WebmasterTD/uEther/README.md

# uEther

uEther is Ethernet exansion card designed for [Clockwork uConsole](https://www.clockworkpi.com/uconsole).

Based on the microchip LAN9500A USB 2.0 to 10/100 Ethernet Bridge.
