WebmasterTD/uEther/3D/uEtherPanel.step

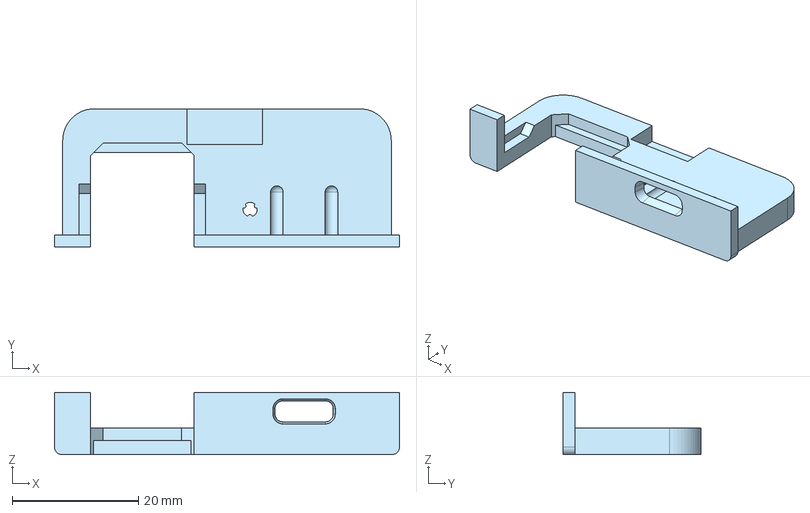
[picture p1: CAD file, 2025-06-16]
3D/uEtherPanel.step
54.6 x 21.9 x 9.85 mm
