WebmasterTD/uEther/(list of files, cad)

Other CAD files:
3D/uEtherPanel.3mf
