WebmasterTD/uEther/docs/2410010003_Korean-Hroparts-Elec-TYPE-C-31-M-12_C165948.pdf

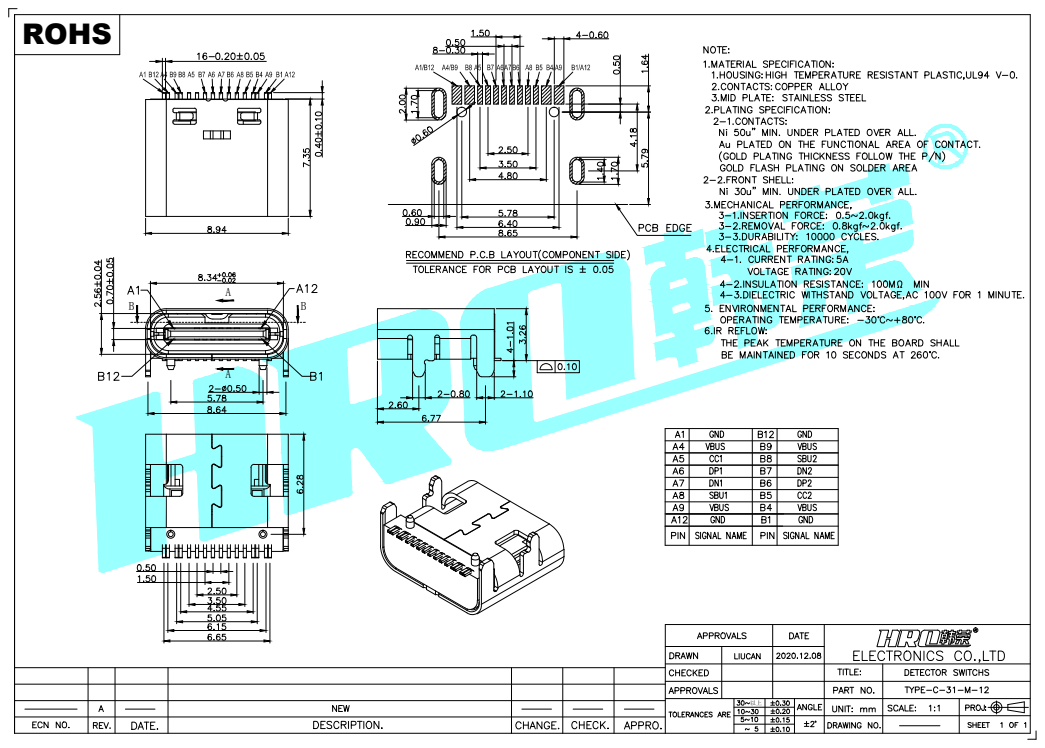
[picture p2: page 1]
