WebmasterTD/uEther/docs/2504101957_XUNPU-RJ45-005-014-11_C7421399.pdf

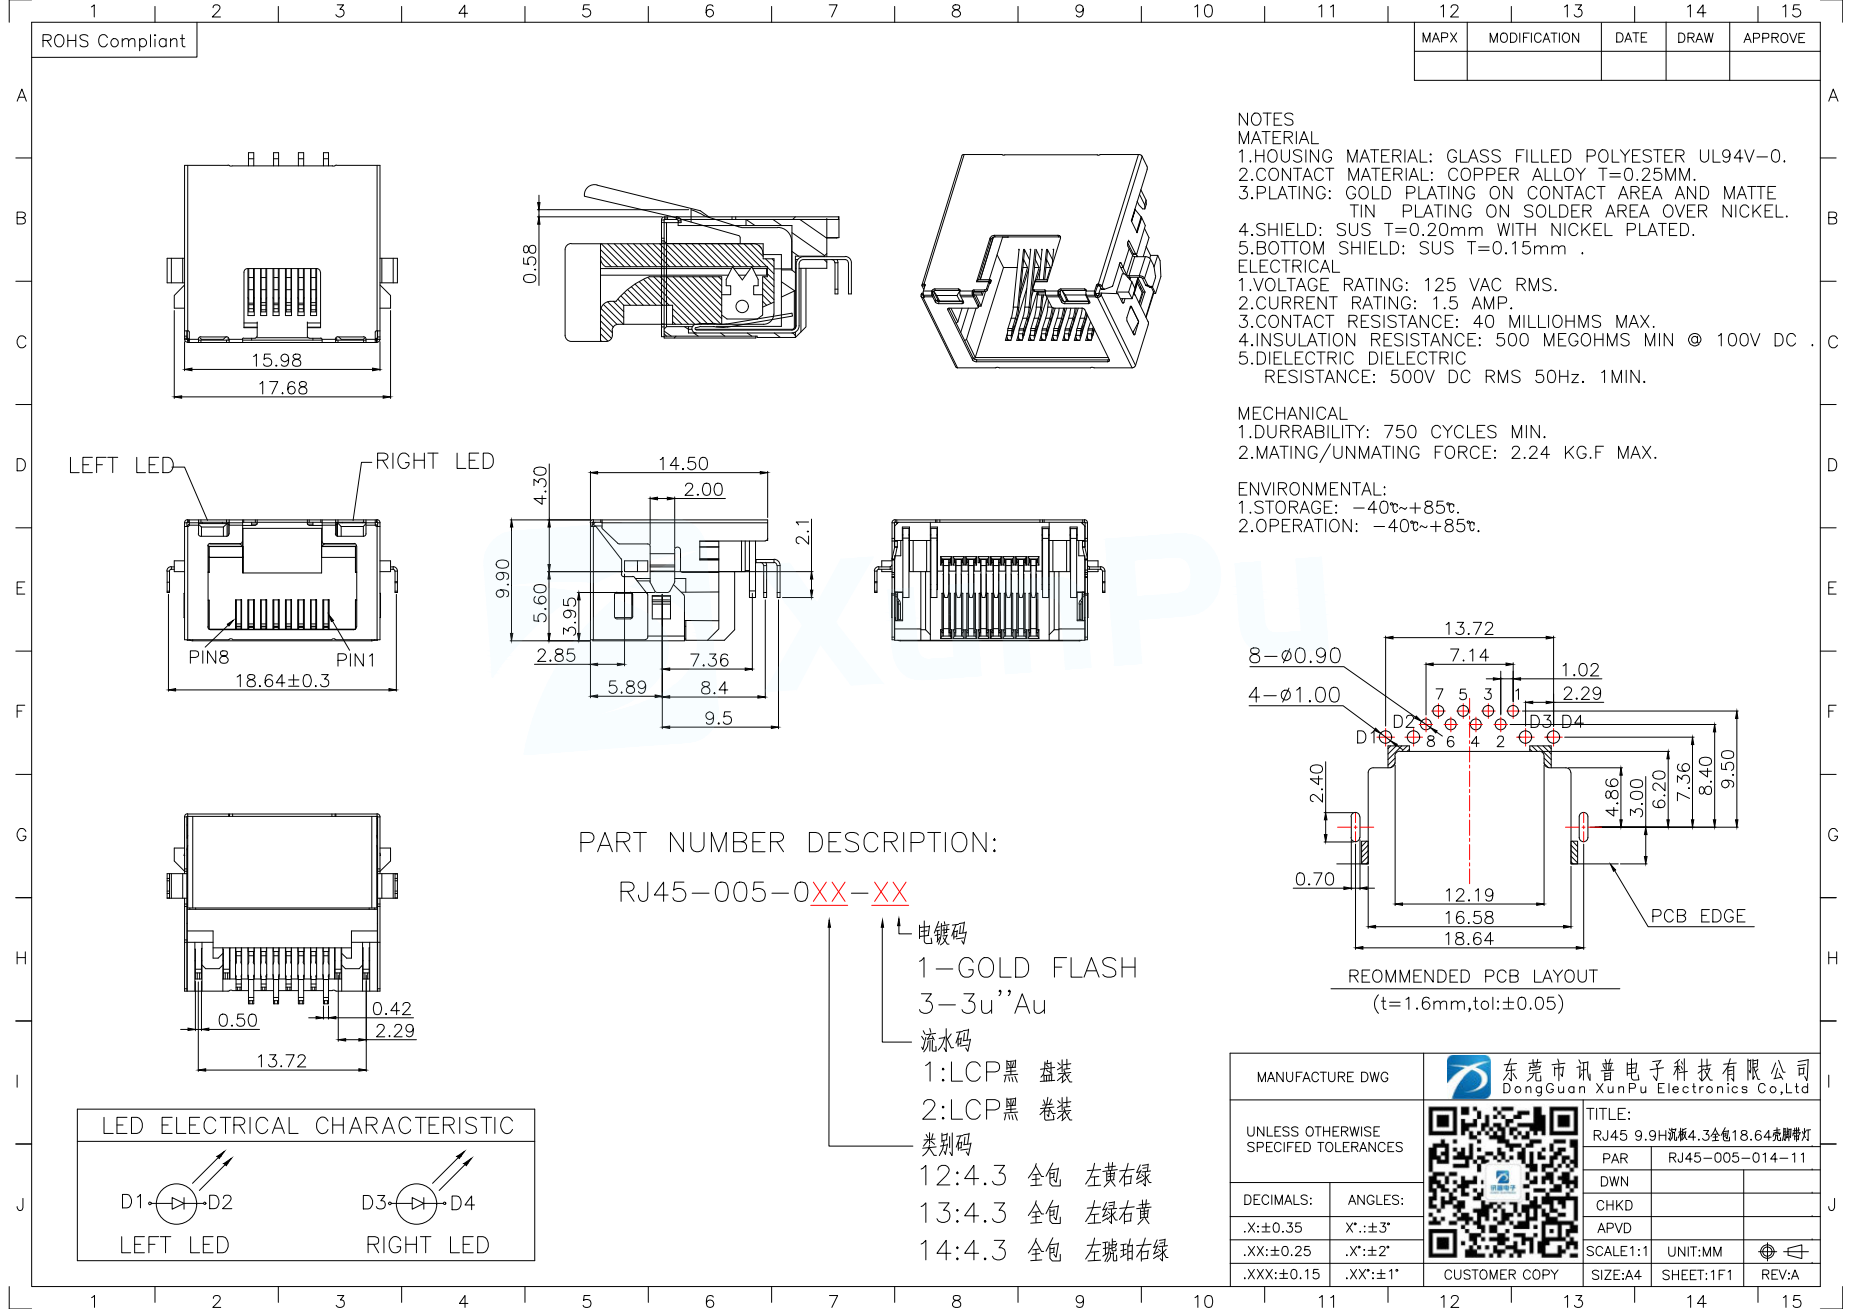
[picture p3: page 1]
