WebmasterTD/uEther/uEther_hw/uEther.kicad_pcb

## KiCad design uEther_hw/uEther.kicad_pcb (2025-04-27)

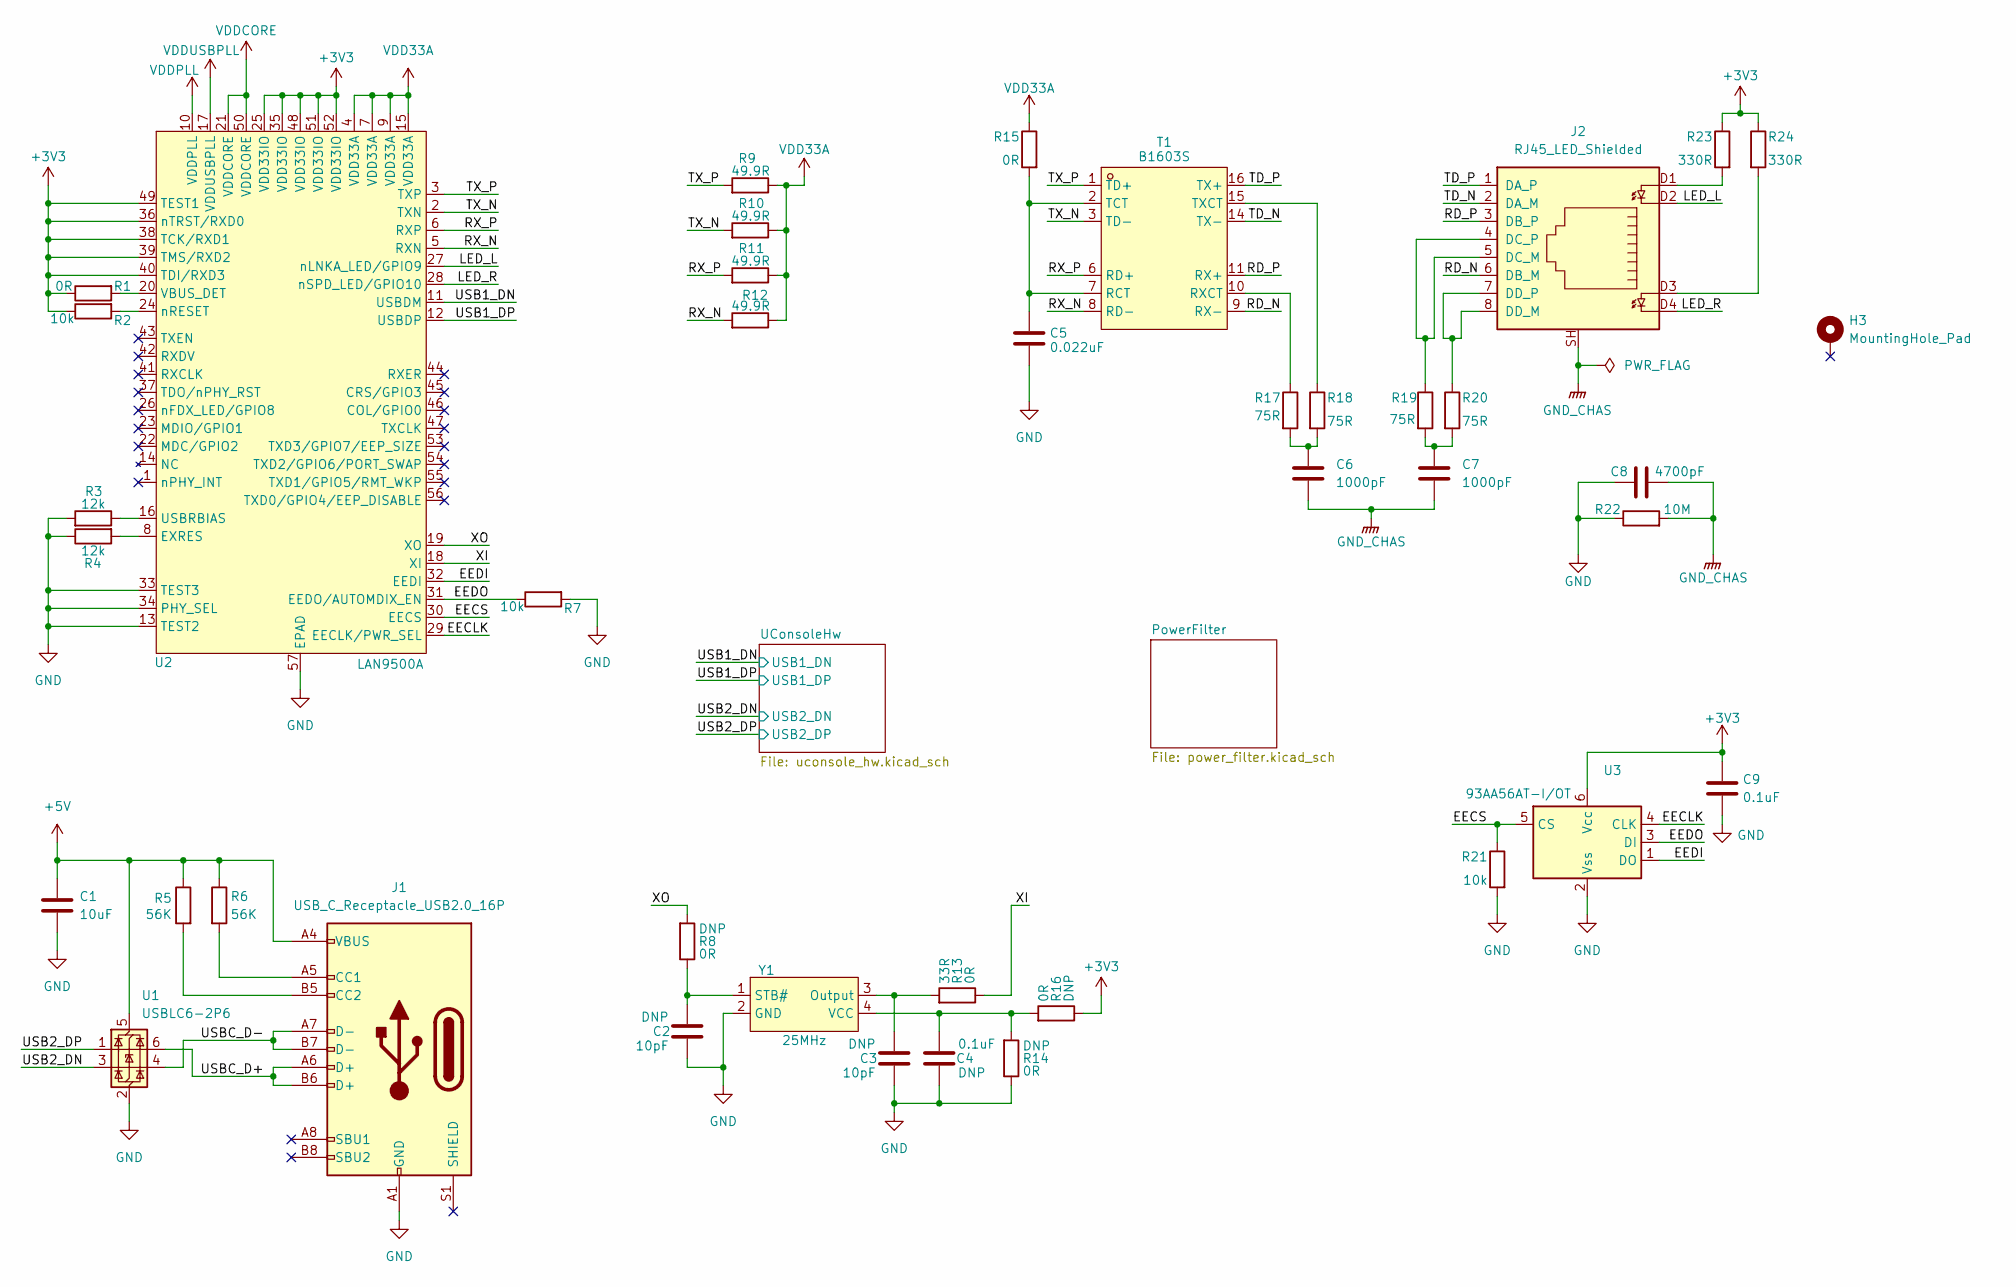
[picture p4: schematic uEther.kicad_sch]

Parts:
C1: 10uF; C_0603_1608Metric
C2, C3, C4: C_0603_1608Metric
C5: 0.022uF; C_0603_1608Metric
C6, C7: 1000pF; C_1206_3216Metric
C8: 4700pF; C_0603_1608Metric
C9: 0.1uF; C_0603_1608Metric
H3: MountingHole_Pad; MountingHole_2.2mm_M2_ISO7380_Pad
J1: USB_C_Receptacle_USB2.0_16P; USB_C_Receptacle_G-Switch_GT-USB-7010ASV
J2: RJ45_LED_Shielded; RJ45-005-014-11
R1, R15: 0R; R_0603_1608Metric
R2, R7, R21: 10k; R_0603_1608Metric
R3, R4: 12k; R_0603_1608Metric
R5, R6: 56K; R_0603_1608Metric
R8, R13, R14, R16: R_0603_1608Metric
R9, R10, R11, R12: 49.9R; R_0603_1608Metric
R17, R18, R19, R20: 75R; R_0603_1608Metric
R22: 10M; R_0603_1608Metric
R23, R24: 330R; R_0603_1608Metric
T1: B1603S; SOIC-16W_7.5x12.8mm_P1.27mm; Manufacturer Part B1603S; LCSC Part Name B1603S
U1: USBLC6-2P6; SOT-666
U2: LAN9500A; QFN-56-1EP_8x8mm_P0.5mm_EP5.9x5.9mm_ThermalVias; Manufacturer Part LAN9500A-ABZJ-TR; LCSC Part Name LAN950x USB 2.0 到 10/100 以太网控制器
U3: 93AA56AT-I/OT; SOT-23-6
Y1: 25MHz; Crystal_SMD_3225-4Pin_3.2x2.5mm; Manufacturer Part DSC1001CI2-025.0000T; LCSC Part Name 25MHz ±25ppm 1.8V~3.3V CMOS

Connections:
+3V3: C9.1, R1.1, R2.1, R16.1, R23.1, R24.1, U2.25 (VDD33IO), U2.35 (VDD33IO), U2.36 (nTRST/RXD0), U2.38 (TCK/RXD1), U2.39 (TMS/RXD2), U2.40 (TDI/RXD3), U2.48 (VDD33IO), U2.49 (TEST1), U2.51 (VDD33IO), U2.52 (VDD33IO), U3.6 (Vcc); also elsewhere on the board
+5V: C1.1, J1.A4 (VBUS), J1.A9 (VBUS), J1.B4 (VBUS), J1.B9 (VBUS), R5.1, R6.1, U1.5 (VBUS); also elsewhere on the board
/EECLK: U2.29 (EECLK/PWR_SEL), U3.4 (CLK)
/EECS: R21.1, U2.30 (EECS), U3.5 (CS)
/EEDI: U2.32 (EEDI), U3.1 (DO)
/EEDO: R7.1, U2.31 (EEDO/AUTOMDIX_EN), U3.3 (DI)
/LED_L: J2.D2, U2.27 (nLNKA_LED/GPIO9)
/LED_R: J2.D4, U2.28 (nSPD_LED/GPIO10)
/RD_N: J2.6 (DB_M), T1.9 (RX-)
/RD_P: J2.3 (DB_P), T1.11 (RX+)
/RX_N: R12.2, T1.8 (RD-), U2.5 (RXN)
/RX_P: R11.2, T1.6 (RD+), U2.6 (RXP)
/TD_N: J2.2 (DA_M), T1.14 (TX-)
/TD_P: J2.1 (DA_P), T1.16 (TX+)
/TX_N: R10.2, T1.3 (TD-), U2.2 (TXN)
/TX_P: R9.2, T1.1 (TD+), U2.3 (TXP)
/USB1_DN: U2.11 (USBDM); also elsewhere on the board
/USB1_DP: U2.12 (USBDP); also elsewhere on the board
/USB2_DN: U1.3 (I/O2); also elsewhere on the board
/USB2_DP: U1.1 (I/O1); also elsewhere on the board
/USBC_D+: J1.A6 (D+), J1.B6 (D+), U1.6 (I/O1)
/USBC_D-: J1.A7 (D-), J1.B7 (D-), U1.4 (I/O2)
/XI: R13.1, U2.18 (XI)
/XO: R8.2, U2.19 (XO)
GND: C1.2, C2.2, C3.2, C4.2, C5.2, C8.1, C9.2, J1.A1 (GND), J1.A12 (GND), J1.B1 (GND), J1.B12 (GND), R3.2, R4.1, R7.2, R14.1, R21.2, R22.1, U1.2 (GND), U2.13 (TEST2), U2.33 (TEST3), U2.34 (PHY_SEL), U2.57 (EPAD), U3.2 (Vss), Y1.2 (GND); also elsewhere on the board
GND_CHAS: C6.2, C7.2, C8.2, J2.SH, R22.2
unnamed: C6.1, R17.2, R18.2
unnamed: C7.1, R19.2, R20.2
unnamed: J1.A5 (CC1), R6.2
unnamed: J1.B5 (CC2), R5.2
unnamed: J2.4 (DC_P), J2.5 (DC_M), R19.1
unnamed: J2.7 (DD_P), J2.8 (DD_M), R20.1
unnamed: J2.D1, R23.2
unnamed: J2.D3, R24.2
unnamed: C5.1, R15.2, T1.2 (TCT), T1.7 (RCT)
unnamed: R17.1, T1.10 (RXCT)
unnamed: R18.1, T1.15 (TXCT)
unnamed: R4.2, U2.8 (EXRES)
unnamed: R3.1, U2.16 (USBRBIAS)
unnamed: R1.2, U2.20 (VBUS_DET)
unnamed: R2.2, U2.24 (nRESET)
unnamed: C3.1, R13.2, Y1.3 (Output)
unnamed: C2.1, R8.1, Y1.1 (STB#)
unnamed: C4.1, R14.2, R16.2, Y1.4 (VCC)
VDD33A: R9.1, R10.1, R11.1, R12.1, R15.1, U2.4 (VDD33A), U2.7 (VDD33A), U2.9 (VDD33A), U2.15 (VDD33A); also elsewhere on the board
VDDCORE: U2.21 (VDDCORE), U2.50 (VDDCORE); also elsewhere on the board
VDDPLL: U2.10 (VDDPLL); also elsewhere on the board
VDDUSBPLL: U2.17 (VDDUSBPLL); also elsewhere on the board

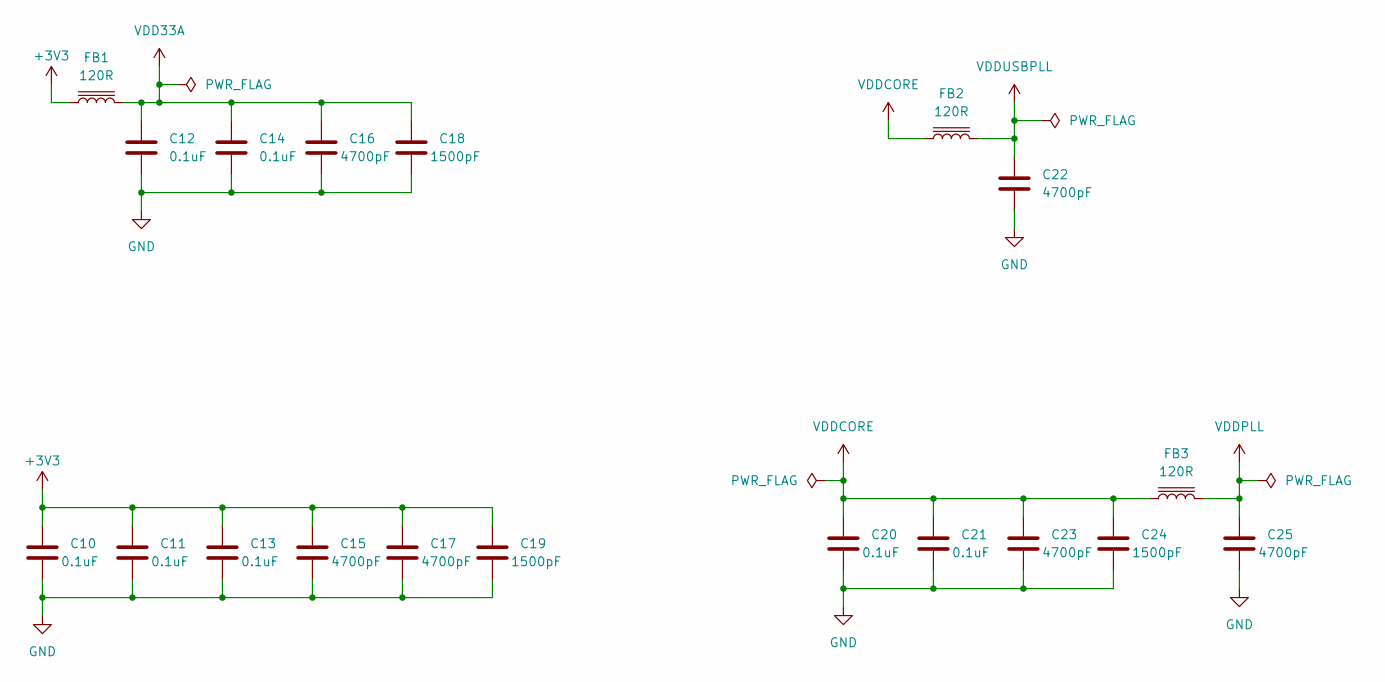
[picture p5: schematic power_filter.kicad_sch, uEther]

Parts:
C10, C11, C12, C13, C14, C20, C21: 0.1uF; C_0603_1608Metric
C15, C16, C17, C22, C23, C25: 4700pF; C_0603_1608Metric
C18, C19, C24: 1500pF; C_0603_1608Metric
FB1, FB2, FB3: 120R; L_0603_1608Metric

Connections:
+3V3: C10.1, C11.1, C13.1, C15.1, C17.1, C19.1, FB1.1; also elsewhere on the board
GND: C10.2, C11.2, C12.2, C13.2, C14.2, C15.2, C16.2, C17.2, C18.2, C19.2, C20.2, C21.2, C22.2, C23.2, C24.2, C25.2; also elsewhere on the board
VDD33A: C12.1, C14.1, C16.1, C18.1, FB1.2; also elsewhere on the board
VDDCORE: C20.1, C21.1, C23.1, C24.1, FB2.1, FB3.1; also elsewhere on the board
VDDPLL: C25.1, FB3.2; also elsewhere on the board
VDDUSBPLL: C22.1, FB2.2; also elsewhere on the board

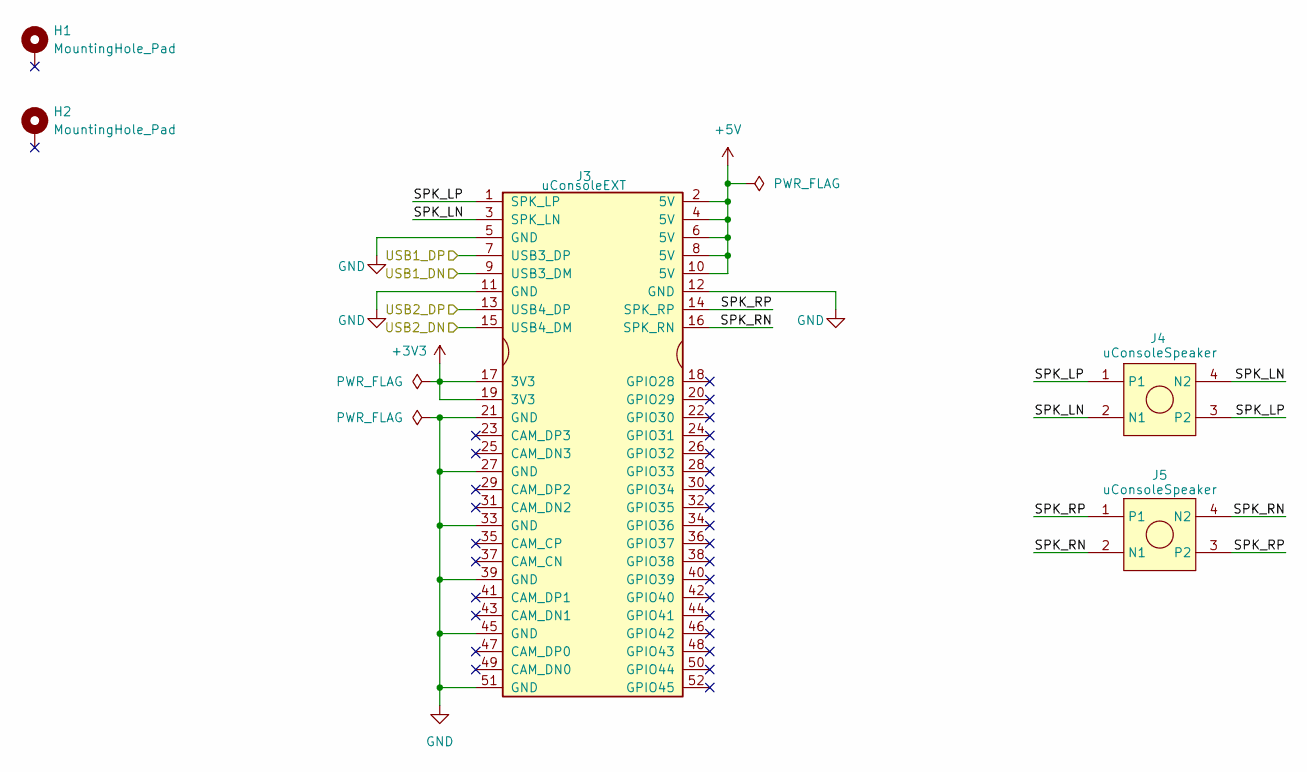
[picture p6: schematic uconsole_hw.kicad_sch, uEther]

Parts:
H1, H2: MountingHole_Pad; MountingHole_5mm_Pad_TopOnly
J3: uConsoleEXT; ext
J4, J5: uConsoleSpeaker; speaker

Connections:
+3V3: J3.17 (3V3), J3.19 (3V3); also elsewhere on the board
+5V: J3.2 (5V), J3.4 (5V), J3.6 (5V), J3.8 (5V), J3.10 (5V); also elsewhere on the board
/UConsoleHw/SPK_LN: J3.3 (SPK_LN), J4.2 (N1), J4.4 (N2)
/UConsoleHw/SPK_LP: J3.1 (SPK_LP), J4.1, J4.3 (P2)
/UConsoleHw/SPK_RN: J3.16 (SPK_RN), J5.2 (N1), J5.4 (N2)
/UConsoleHw/SPK_RP: J3.14 (SPK_RP), J5.1, J5.3 (P2)
/USB1_DN: J3.9 (USB3_DM); also elsewhere on the board
/USB1_DP: J3.7 (USB3_DP); also elsewhere on the board
/USB2_DN: J3.15 (USB4_DM); also elsewhere on the board
/USB2_DP: J3.13 (USB4_DP); also elsewhere on the board
GND: J3.5 (GND), J3.11 (GND), J3.12 (GND), J3.21 (GND), J3.27 (GND), J3.33 (GND), J3.39 (GND), J3.45 (GND), J3.51 (GND); also elsewhere on the board

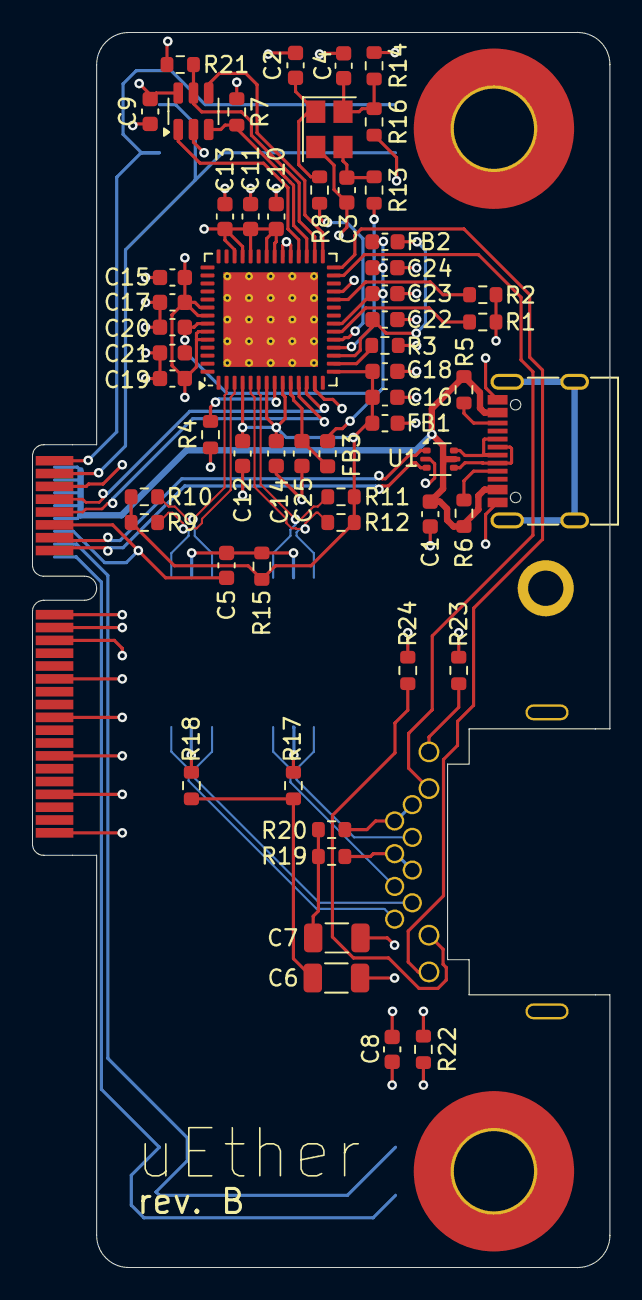
[picture p7: board uEther.kicad_pcb from above]

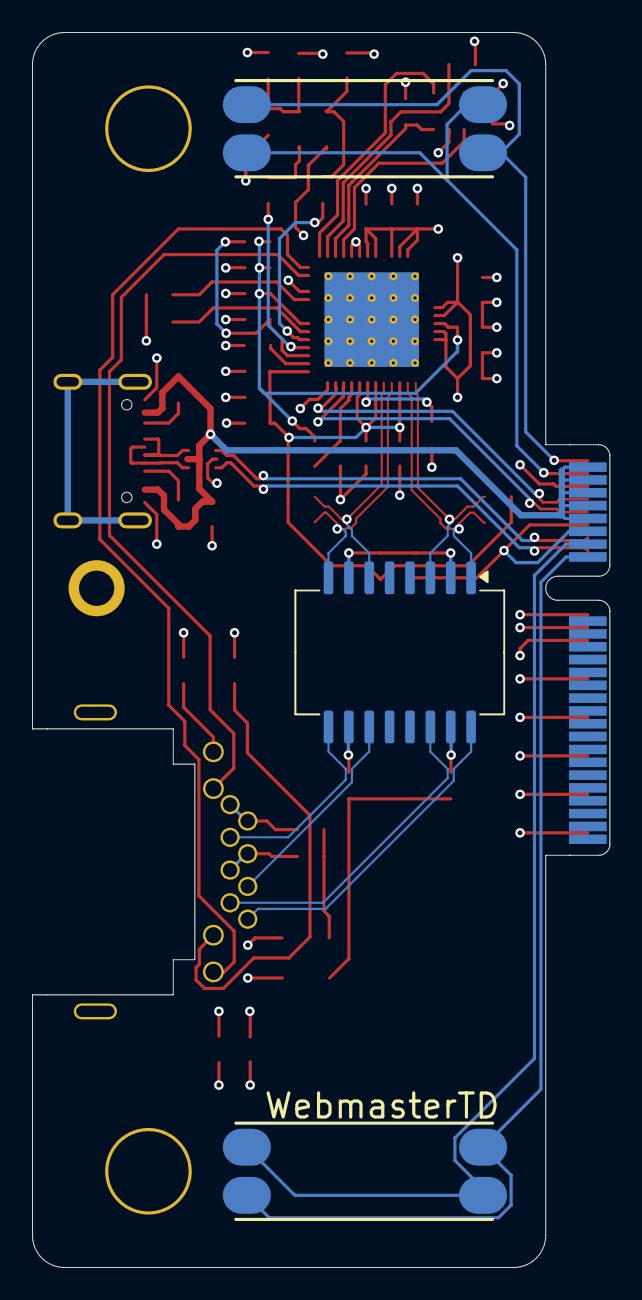
[picture p8: board uEther.kicad_pcb from below]

Board: 4 copper layers, 36.0 x 77.0 mm, 65 parts (4 on the bottom side), 52 nets.
