WebmasterTD/uEther/(commit log)

2025-04-03 changed print profile
    [uEtherPanel.3mf]
2025-04-11 Changed Schematic
    [power_filter.kicad_sch, uEther.kicad_sch, uconsole_hw.kicad_sch]
2025-04-12 Schematic for rev B
    [power_filter.kicad_sch, uEther.kicad_pcb, uEther.kicad_sch, uconsole_hw.kicad_sch]
2025-04-13 reworked PCB
    [uEther.kicad_pcb, uEther.kicad_sch]
2025-04-16 design rev B
    [uEther.kicad_pcb]
2025-04-27 updated 3D files
    [uEtherPanel.3mf, uEtherPanel.step]
2025-06-16 Updated 3D files files
    [uEtherPanel.3mf, uEtherPanel.step]
